Jochen0x90h/LedControl/README.md

# LED Control

Control unit for LED strips

## Features
* 128x64 OLED Display
* Support for presets, i.e. the same effect can be configured with different parameters in the preset list

## Compile
See README.md of coco base library
