Jochen0x90h/LedControl/pcb/g431Triple/control.kicad_pcb

## KiCad design pcb/g431Triple/control.kicad_pcb (2026-03-05)

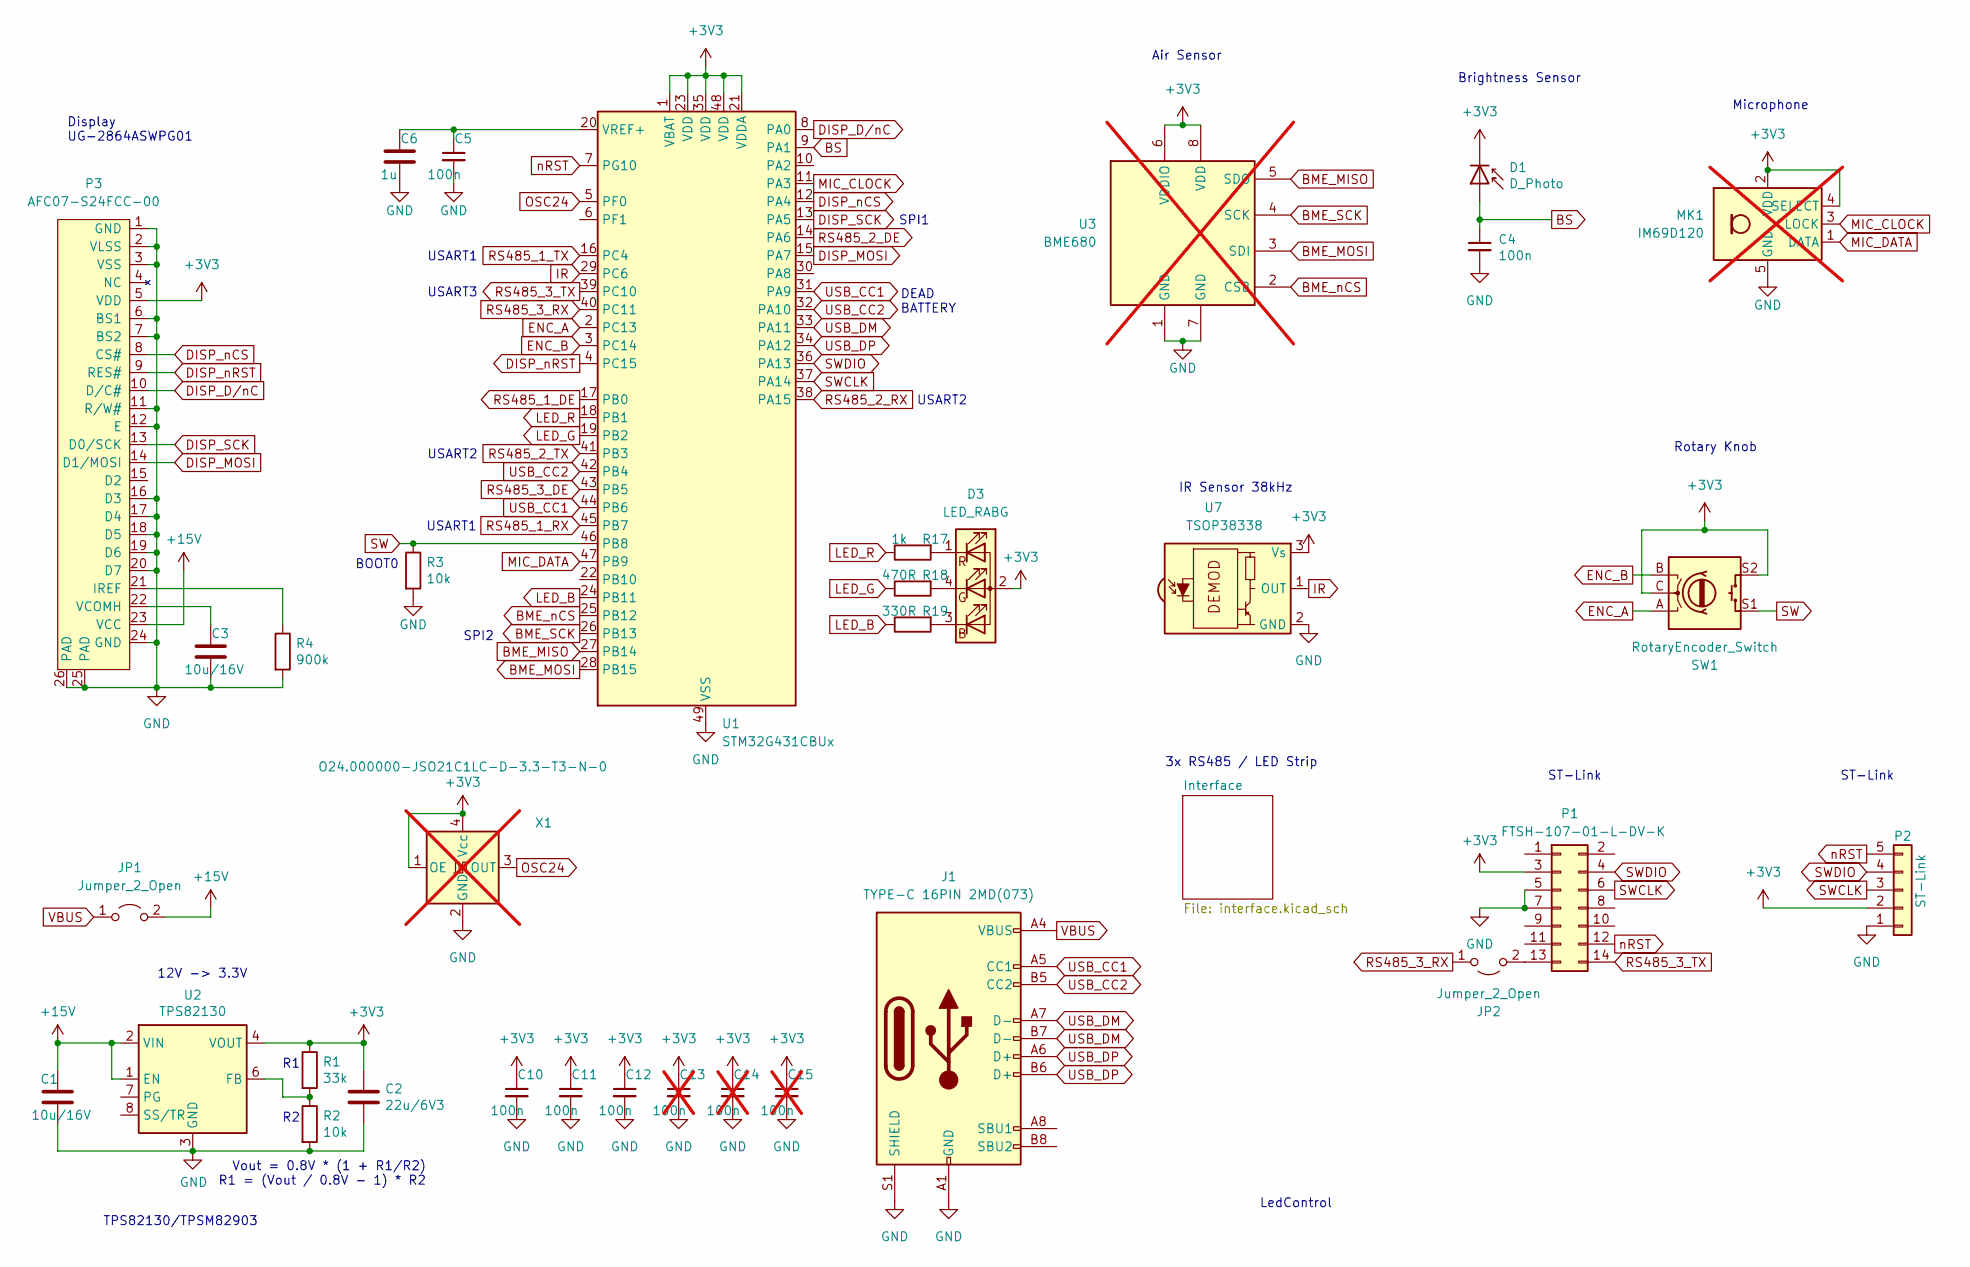
[picture p1: schematic control.kicad_sch]

Parts:
C1, C3: 10u/16V; 1206
C2: 22u/6V3; 0805
C4, C5, C10, C11, C12: 100n; 0603
C6: 1u; 0603
C13, C14, C15: 100n; 0603; not fitted
D1: D_Photo; PhotoDiode
D3: LED_RABG; LED_D5.0mm-4_RGB
J1: TYPE-C 16PIN 2MD(073); TYPE-C-16PIN-2MD-073
JP1, JP2: Jumper_2_Open; Jumper
MK1: IM69D120; Infineon_PG-LLGA-5-1; not fitted
P1: FTSH-107-01-L-DV-K; PinHeader-2x7-1.27mm-smd
P2: ST-Link; ProgPads
P3: AFC07-S24FCC-00; Connector-Flat-24-0.5mm
R1: 33k; 0603
R2, R3: 10k; 0603
R4: 900k; 0603
R17: 1k; 0603
R18: 470R; 0603
R19: 330R; 0603
SW1: RotaryEncoder_Switch; PEC12R-4217F-S0024
U1: STM32G431CBUx; STM32-UFQFPN48
U2: TPS82130
U3: BME680; not fitted
U7: TSOP38338
X1: O24.000000-JSO21C1LC-D-3.3-T3-N-0; JSO21; not fitted

Connections:
+3V3: C2.1, C10.1, C11.1, C12.1, C13.1, C14.1, C15.1, D1.1 (K), D3.2 (A), MK1.2 (VDD), MK1.4 (SELECT), P1.3, P2.2, P3.5 (VDD), R1.1, SW1.C, SW1.S2, U1.1 (VBAT), U1.21 (VDDA), U1.23 (VDD), U1.35 (VDD), U1.48 (VDD), U2.4 (VOUT), U2.5 (VOUT), U3.6 (VDDIO), U3.8 (VDD), U7.3 (Vs), X1.1 (OE), X1.4 (Vcc); also elsewhere on the board
+15V: C1.1, JP1.2 (B), P3.23 (VCC), U2.1 (EN), U2.2 (VIN); also elsewhere on the board
BME_MISO: U1.27 (PB14), U3.5 (SDO)
BME_MOSI: U1.28 (PB15), U3.3 (SDI)
BME_SCK: U1.26 (PB13), U3.4 (SCK)
BME_nCS: U1.25 (PB12), U3.2 (CSB)
BS: C4.1, D1.2 (A), U1.9 (PA1)
DISP_D/nC: P3.10 (D/C#), U1.8 (PA0)
DISP_MOSI: P3.14 (D1/MOSI), U1.15 (PA7)
DISP_SCK: P3.13 (D0/SCK), U1.13 (PA5)
DISP_nCS: P3.8 (CS#), U1.12 (PA4)
DISP_nRST: P3.9 (RES#), U1.4 (PC15)
ENC_A: SW1.A, U1.2 (PC13)
ENC_B: SW1.B, U1.3 (PC14)
GND: C1.2, C2.2, C3.2, C4.2, C5.2, C6.2, C10.2, C11.2, C12.2, C13.2, C14.2, C15.2, J1.A1 (GND), J1.A12 (GND), J1.B1 (GND), J1.B12 (GND), J1.S1 (SHIELD), MK1.5 (GND), P1.5, P1.7, P2.1, P3.1 (GND), P3.2 (VLSS), P3.3 (VSS), P3.6 (BS1), P3.7 (BS2), P3.11 (R/W#), P3.12 (E), P3.16 (D3), P3.17 (D4), P3.18 (D5), P3.19 (D6), P3.20 (D7), P3.24 (GND), P3.25 (PAD), P3.26 (PAD), R2.2, R3.2, R4.2, U1.49 (VSS), U2.3 (GND), U2.9 (GND), U3.1 (GND), U3.7 (GND), U7.2 (GND), X1.2 (GND); also elsewhere on the board
IR: U1.29 (PC6), U7.1 (OUT)
LED_B: R19.1, U1.24 (PB11)
LED_G: R18.1, U1.19 (PB2)
LED_R: R17.1, U1.18 (PB1)
MIC_CLOCK: MK1.3 (CLOCK), U1.11 (PA3)
MIC_DATA: MK1.1 (DATA), U1.47 (PB9)
unnamed: D3.3 (BK), R19.2
unnamed: D3.4 (GK), R18.2
unnamed: D3.1 (RK), R17.2
unnamed: JP2.2 (B), P1.13
unnamed: P3.21 (IREF), R4.1
unnamed: C3.1, P3.22 (VCOMH)
unnamed: C5.1, C6.1, U1.20 (VREF+)
unnamed: R1.2, R2.1, U2.6 (FB)
OSC24: U1.5 (PF0), X1.3 (OUT)
RS485_1_DE: U1.17 (PB0); also elsewhere on the board
RS485_1_RX: U1.45 (PB7); also elsewhere on the board
RS485_1_TX: U1.16 (PC4); also elsewhere on the board
RS485_2_DE: U1.14 (PA6); also elsewhere on the board
RS485_2_RX: U1.38 (PA15); also elsewhere on the board
RS485_2_TX: U1.41 (PB3); also elsewhere on the board
RS485_3_DE: U1.43 (PB5); also elsewhere on the board
RS485_3_RX: JP2.1 (A), U1.40 (PC11); also elsewhere on the board
RS485_3_TX: P1.14, U1.39 (PC10); also elsewhere on the board
SW: R3.1, SW1.S1, U1.46 (PB8)
SWCLK: P1.6, P2.3, U1.37 (PA14)
SWDIO: P1.4, P2.4, U1.36 (PA13)
USB_CC1: J1.A5 (CC1), U1.31 (PA9), U1.44 (PB6)
USB_CC2: J1.B5 (CC2), U1.32 (PA10), U1.42 (PB4)
USB_DM: J1.A7 (D-), J1.B7 (D-), U1.33 (PA11)
USB_DP: J1.A6 (D+), J1.B6 (D+), U1.34 (PA12)
VBUS: J1.A4 (VBUS), J1.A9 (VBUS), J1.B4 (VBUS), J1.B9 (VBUS), JP1.1 (A)
nRST: P1.12, P2.5, U1.7 (PG10)

Notes on the sheet:
12V -> 3.3V
BOOT0
SPI2
USART2
ST-Link
Vout = 0.8V * (1 + R1/R2) R1 = (Vout / 0.8V - 1) * R2
DEAD BATTERY
Display UG-2864ASWPG01
Air Sensor
USART3
Microphone
LedControl
3x RS485 / LED Strip
USART1
Brightness Sensor
TPS82130/TPSM82903
IR Sensor 38kHz
SPI1
Rotary Knob

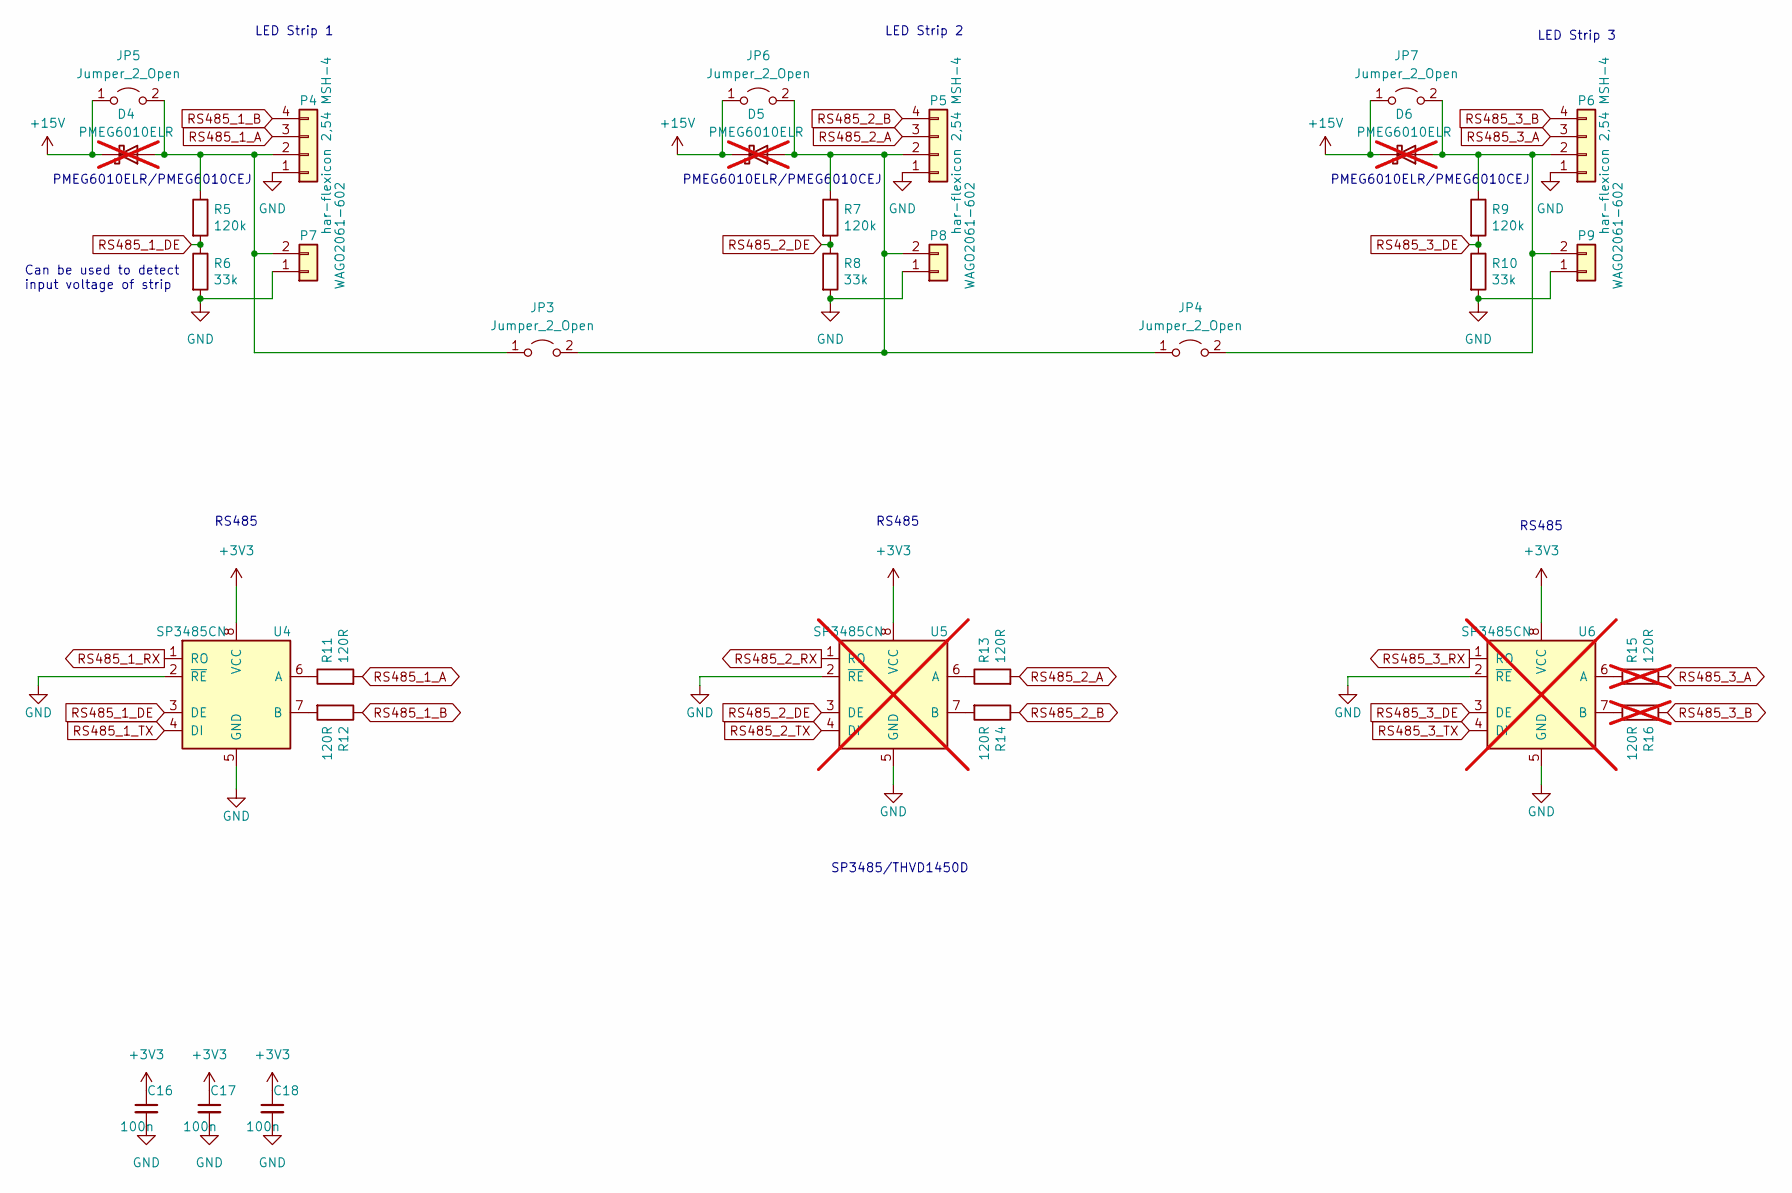
[picture p2: schematic interface.kicad_sch]

Parts:
C16, C17, C18: 100n; 0603
D4, D5, D6: PMEG6010ELR; not fitted
JP3, JP4, JP5, JP6, JP7: Jumper_2_Open; Jumper
P4, P5, P6: har-flexicon 2,54 MSH-4; Harting14110413002000
P7, P8, P9: WAGO2061-602
R5, R7, R9: 120k; 0603
R6, R8, R10: 33k; 0603
R11, R12, R13, R14: 120R; 1206-term
R15, R16: 120R; 1206-term; not fitted
U4: SP3485CN; SO-8
U5, U6: SP3485CN; SO-8; not fitted

Connections:
+3V3: C16.1, C17.1, C18.1, U4.8 (VCC), U5.8 (VCC), U6.8 (VCC); also elsewhere on the board
+15V: D4.1 (K), D5.1 (K), D6.1 (K), JP5.1 (A), JP6.1 (A), JP7.1 (A); also elsewhere on the board
GND: C16.2, C17.2, C18.2, P4.1, P5.1, P6.1, P7.1, P8.1, P9.1, R6.2, R8.2, R10.2, U4.2 (~RE), U4.5 (GND), U5.2 (~RE), U5.5 (GND), U6.2 (~RE), U6.5 (GND); also elsewhere on the board
unnamed: D4.2 (A), JP3.1 (A), JP5.2 (B), P4.2, P7.2, R5.1
unnamed: D5.2 (A), JP3.2 (B), JP4.1 (A), JP6.2 (B), P5.2, P8.2, R7.1
unnamed: D6.2 (A), JP4.2 (B), JP7.2 (B), P6.2, P9.2, R9.1
unnamed: R11.1, U4.6 (A)
unnamed: R12.2, U4.7 (B)
unnamed: R13.1, U5.6 (A)
unnamed: R14.2, U5.7 (B)
unnamed: R15.1, U6.6 (A)
unnamed: R16.2, U6.7 (B)
RS485_1_A: P4.3, R11.2
RS485_1_B: P4.4, R12.1
RS485_1_DE: R5.2, R6.1, U4.3 (DE); also elsewhere on the board
RS485_1_RX: U4.1 (RO); also elsewhere on the board
RS485_1_TX: U4.4 (DI); also elsewhere on the board
RS485_2_A: P5.3, R13.2
RS485_2_B: P5.4, R14.1
RS485_2_DE: R7.2, R8.1, U5.3 (DE); also elsewhere on the board
RS485_2_RX: U5.1 (RO); also elsewhere on the board
RS485_2_TX: U5.4 (DI); also elsewhere on the board
RS485_3_A: P6.3, R15.2
RS485_3_B: P6.4, R16.1
RS485_3_DE: R9.2, R10.1, U6.3 (DE); also elsewhere on the board
RS485_3_RX: U6.1 (RO); also elsewhere on the board
RS485_3_TX: U6.4 (DI); also elsewhere on the board

Notes on the sheet:
Can be used to detect input voltage of strip
LED Strip 3
PMEG6010ELR/PMEG6010CEJ
LED Strip 1
SP3485/THVD1450D
LED Strip 2
RS485

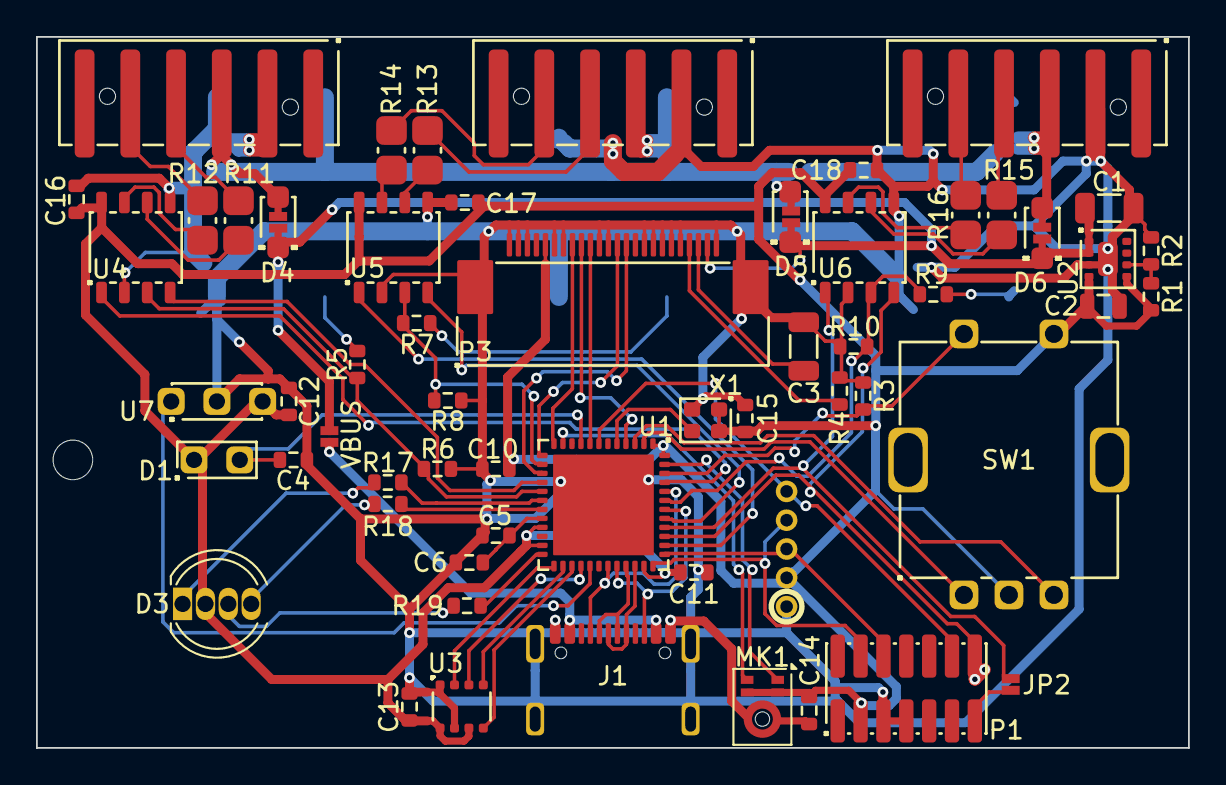
[picture p3: board control.kicad_pcb from above]

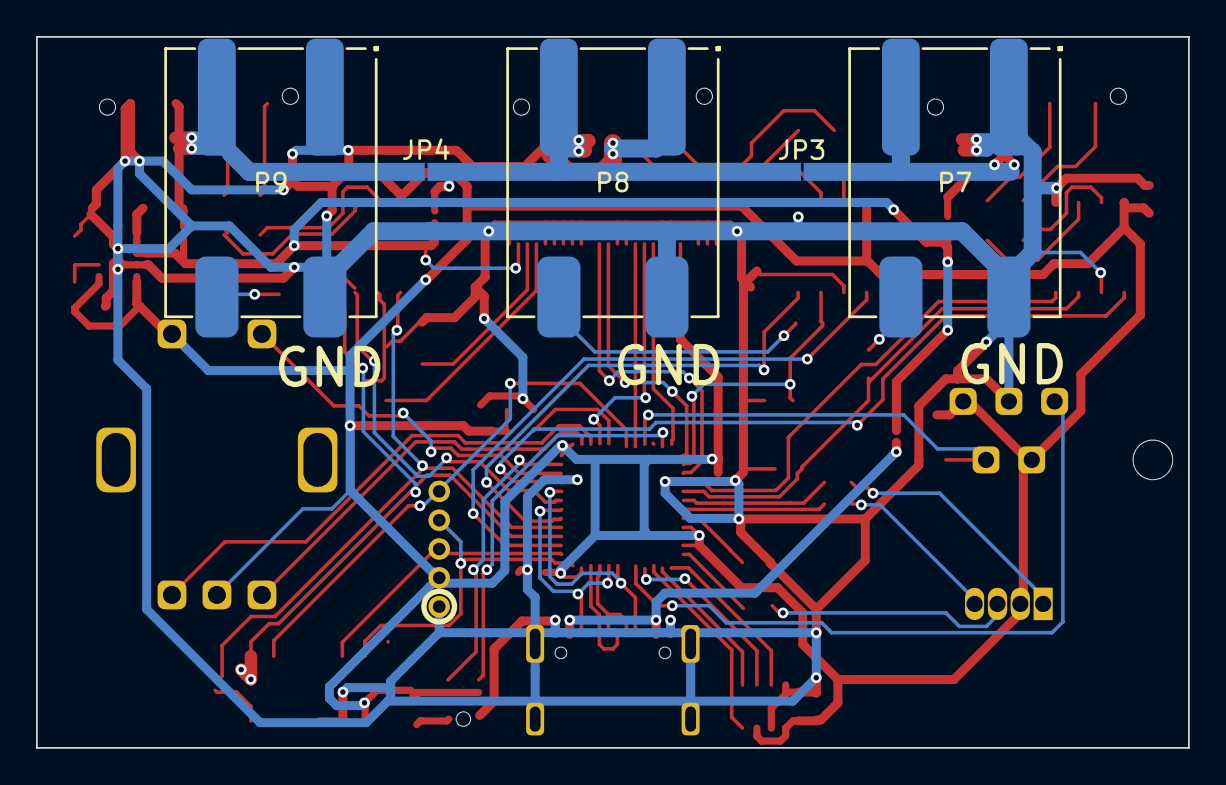
[picture p4: board control.kicad_pcb from below]

Board: 2 copper layers, 64.0 x 39.5 mm, 66 parts (6 on the bottom side), 63 nets.
