Jochen0x90h/LedControl/pcb/g431Triple/control.ioc

Mcu.UserName=STM32G431CBUx
PA0.GPIO_Label=DISP_D/C\#
PA0.Signal=GPIO_Output
PA1.Signal=COMP1_INP
PA10.Signal=UCPD1_DBCC2
PA11.Signal=USB_DM
PA12.Signal=USB_DP
PA13.Signal=SYS_JTMS-SWDIO
PA14.Signal=SYS_JTCK-SWCLK
PA15.Signal=USART2_RX
PA2.Signal=OPAMP1_VOUT
PA3.Signal=SAI1_CK1
PA4.GPIO_Label=DISP_CS
PA4.Signal=GPIO_Output
PA5.Signal=SPI1_SCK
PA6.GPIO_Label=RS485_2_DE
PA6.Signal=GPIO_Output
PA7.Signal=SPI1_MOSI
PA9.Signal=UCPD1_DBCC1
PB0.GPIO_Label=RS485_DE
PB0.Signal=GPIO_Output
PB1.Signal=OPAMP3_VOUT
PB12.GPIO_Label=BME_CS
PB12.Signal=GPIO_Output
PB13.Signal=SPI2_SCK
PB14.Signal=SPI2_MISO
PB15.Signal=SPI2_MOSI
PB2.Signal=OPAMP3_VINM
PB3.Signal=USART2_TX
PB4.Signal=UCPD1_CC2
PB5.GPIO_Label=RS485_3_DE
PB5.Signal=GPIO_Output
PB6.Signal=UCPD1_CC1
PB7.Signal=USART1_RX
PB8-BOOT0.GPIO_Label=SW
PB8-BOOT0.Signal=GPIO_Input
PB9.Signal=SAI1_D2
PC10.Signal=USART3_TX
PC11.Signal=USART3_RX
PC13.GPIO_Label=ENC_A
PC13.Signal=GPIO_Input
PC14-OSC32_IN.GPIO_Label=ENC_B
PC14-OSC32_IN.Signal=GPIO_Input
PC15-OSC32_OUT.GPIO_Label=DISP_RESET
PC15-OSC32_OUT.Signal=GPIO_Output
PC4.Signal=USART1_TX
PC6.Signal=S_TIM3_CH1
PG10-NRST.GPIO_Label=nRST
PG10-NRST.Signal=GPIO_Input
