Jochen0x90h/LedControl/generator/colorTemperature.hpp

#pragma once

#include <cstdint>


// color temperature
// http://www.vendian.org/mncharity/dir3/blackbody/UnstableURLs/bbr_color.html
struct ColorTemperature {
    int temperature;

    // {2, 10}, either CIE 1931 2 degree CMFs with Judd Vos corrections or CIE 1964 10 degree CMFs
    int step;

    // chromaticity
    float x;
    float y;

    // power in semi-arbitrary units
    float power;

    // {0-1}, normalized, mapped to gamut, logrithmic (sRGB primaries and gamma correction)
    float sr;
    float sg;
    float sb;

    // {0-255}
    uint8_t r;
    uint8_t g;
    uint8_t b;
};

const ColorTemperature colorTemperatures[] = {
    { 1000,  2, 0.6499f, 0.3474f, 2.472e+06, 1.0000f, 0.0337f, 0.0000f, 255,  51,   0},
    { 1000, 10, 0.6472f, 0.3506f, 2.525e+06, 1.0000f, 0.0401f, 0.0000f, 255,  56,   0},
    { 1100,  2, 0.6361f, 0.3594f, 2.112e+07, 1.0000f, 0.0592f, 0.0000f, 255,  69,   0},
    { 1100, 10, 0.6348f, 0.3612f, 2.162e+07, 1.0000f, 0.0631f, 0.0000f, 255,  71,   0},
    { 1200,  2, 0.6226f, 0.3703f, 1.282e+08, 1.0000f, 0.0846f, 0.0000f, 255,  82,   0},
    { 1200, 10, 0.6225f, 0.3710f, 1.314e+08, 1.0000f, 0.0860f, 0.0000f, 255,  83,   0},
    { 1300,  2, 0.6095f, 0.3801f, 5.959e+08, 1.0000f, 0.1096f, 0.0000f, 255,  93,   0},
    { 1300, 10, 0.6104f, 0.3797f, 6.118e+08, 1.0000f, 0.1085f, 0.0000f, 255,  93,   0},
    { 1400,  2, 0.5966f, 0.3887f, 2.243e+09, 1.0000f, 0.1341f, 0.0000f, 255, 102,   0},
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
    { 2800, 10, 0.4555f, 0.4071f, 1.604e+13, 1.0000f, 0.4195f, 0.1119f, 255, 173,  94},
    { 2900,  2, 0.4460f, 0.4118f, 2.081e+13, 1.0000f, 0.4668f, 0.1229f, 255, 182,  98},
    { 2900, 10, 0.4478f, 0.4050f, 2.193e+13, 1.0000f, 0.4394f, 0.1297f, 255, 177, 101},
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
};
