Jochen0x90h/LedControl/src/g431Triple/SystemInit.cpp

#include "config.hpp"
#include <coco/debug.hpp>
#include <coco/platform/platform.hpp>


// called from startup code to setup clock and flash before static constructors and main()
// pass -Wl,--undefined=SystemInit to gcc in addition to -Wl,--gc-sections to prevent the function from being garbage collected
extern "C" {
void __attribute__((weak)) SystemInit() {
    /*
        Use HSI, set system clock to 160MHz and peripheral clocks to 40MHz
        HSI is 16MHz
        HSE is 24MHz

        Reference manual Table 9
        Wait states  Range 1 boost  Range 1 normal  Range 2
        0WS           34MHz          30MHz           12MHz
        1WS           68MHz          60MHz           24MHz
        2WS          102MHz          90MHz           26MHz
        3WS          136MHz         120MHz
        4WS          170MHz         150MHz
    */

    // enable clock of PWR
    RCC->APB1ENR1 = RCC->APB1ENR1 | RCC_APB1ENR1_PWREN;

    // set flash latency
    FLASH->ACR = FLASH_ACR_LATENCY_4WS // 4 wait states
        | FLASH_ACR_ICEN // instruction cache enable
        | FLASH_ACR_DCEN // data cache enable
        | FLASH_ACR_PRFTEN // prefetch enable
        | FLASH_ACR_DBG_SWEN; // debug enable

    // configure PLL: 16MHz / 1 * 20 = 320MHz
    RCC->PLLCFGR = RCC_PLLCFGR_PLLSRC_HSI // source is internal oscillator HSI16
        | ((1 - 1) << RCC_PLLCFGR_PLLM_Pos) // /M
        | (20 << RCC_PLLCFGR_PLLN_Pos) // *N
        | RCC_PLLCFGR_PLLREN // enable PLLR output, PLLR: 320MHz / 2 = 160MHz (set SYS_CLOCK in config.hpp accordingly)
        | RCC_PLLCFGR_PLLPEN // enable PLLP output (for ADC)
        | (7 << RCC_PLLCFGR_PLLPDIV_Pos); // PLLP: 320MHz / 7 = 45.7MHz

    // enable internal oscillator and PLL
    RCC->CR = 0x63 // bits 0-7 must be kept at reset value
        | RCC_CR_HSION // enable internal oscillator
        | RCC_CR_PLLON; // enable PLL

    // set boost mode
    PWR->CR5 = 0;

    // wait until PLL is ready
    while (!(RCC->CR & RCC_CR_PLLRDY)) {}

    // use PLL, set APB1 and APB2 prescaler
    uint32_t cfgr = RCC_CFGR_SW_PLL // use PLL
        | RCC_CFGR_PPRE1_DIV8 // APB1_CLOCK = AHB_CLOCK / 8 (set divisors in config.hpp accordingly)
        | RCC_CFGR_PPRE2_DIV8; // APB2_CLOCK = AHB_CLOCK / 8

    // switch to medium speed clock, wait for at least 1us according to reference manual 7.2.7, then switch to high speed clock
    RCC->CFGR = cfgr | RCC_CFGR_HPRE_DIV2; // medium speed: AHB_CLOCK = SYS_CLOCK / 2
    for (int i = 0; i < 170; ++i)
        __NOP();

    // switch to high speed clock
    RCC->CFGR = cfgr | RCC_CFGR_HPRE_DIV1; // high speed: AHB_CLOCK = SYS_CLOCK

    // set clock source of ADC to PLLP
    RCC->CCIPR = RCC->CCIPR | RCC_CCIPR_ADC12SEL_0;

    // enable FPU, depends on compiler flags
#if (__FPU_USED == 1)
    SCB->CPACR = SCB->CPACR | (3UL << 20) | (3UL << 22);
    __DSB();
    __ISB();
#else
    #warning "FPU is not used"
#endif


    // enable clocks of GPIO and SYSCFG
    RCC->AHB2ENR = RCC->AHB2ENR
        | RCC_AHB2ENR_GPIOAEN
        | RCC_AHB2ENR_GPIOBEN
        | RCC_AHB2ENR_GPIOCEN;
        //| RCC_AHB2ENR_GPIODEN
        //| RCC_AHB2ENR_GPIOEEN
        //| RCC_AHB2ENR_GPIOFEN;
    RCC->APB2ENR = RCC->APB2ENR | RCC_APB2ENR_SYSCFGEN;

    // enable clock of CORDIC
    //RCC->AHB1ENR = RCC->AHB1ENR | RCC_AHB1ENR_CORDICEN;

    // disable dead battery pull-ups (when not using UCPD, otherwise do this after initializing UCPD)
    //PWR->CR3 = PWR->CR3 | PWR_CR3_UCPD_DBDIS;

    // enable reference voltage
    //vref::enable(vref::Config::INTERNAL_2V9);

    coco::debug::init();
}
}
