Jochen0x90h/LedControl/(commit log)

2024-10-03 Cleanup, add casing
    [control.kicad_pcb, control.kicad_sch, control.scad, interface.kicad_sch]
2024-11-11 Add IR receiver
    [control.kicad_pcb, control.kicad_sch, control.scad, interface.kicad_sch]
2024-12-22 Control brightness and duraton with remote control
    [control.kicad_pcb, control.kicad_sch, control.scad, interface.kicad_sch]
2025-01-26 Add SnowSparkle, new footprints
    [control.kicad_pcb, control.kicad_sch, interface.kicad_sch]
2025-04-14 Use TSOP38338
    [control.kicad_pcb, control.kicad_sch]
2025-05-01 Rename to g431/g431Triple, new pin ordering for Harting connector
    [control.kicad_pcb, control.kicad_sch, interface.kicad_sch]
2025-05-24 Multiple led strips
    [control.kicad_pcb, control.kicad_sch]
2025-06-16 Add color temperature
    [control.kicad_pcb, control.kicad_sch, interface.kicad_sch]
2025-10-05 Start preset name editor
    [control.kicad_pcb, control.kicad_sch, interface.kicad_sch]
2025-10-20 Display preset names
    [control.kicad_sch]
2026-03-05 Works on g431Triple
    [control.kicad_pcb, control.kicad_sch, interface.kicad_sch]
